gfhuth/ecg-instru/kicad/ecg-instru/ecg-instru.kicad_pcb

## KiCad design kicad/ecg-instru/ecg-instru.kicad_pcb (2025-06-29)

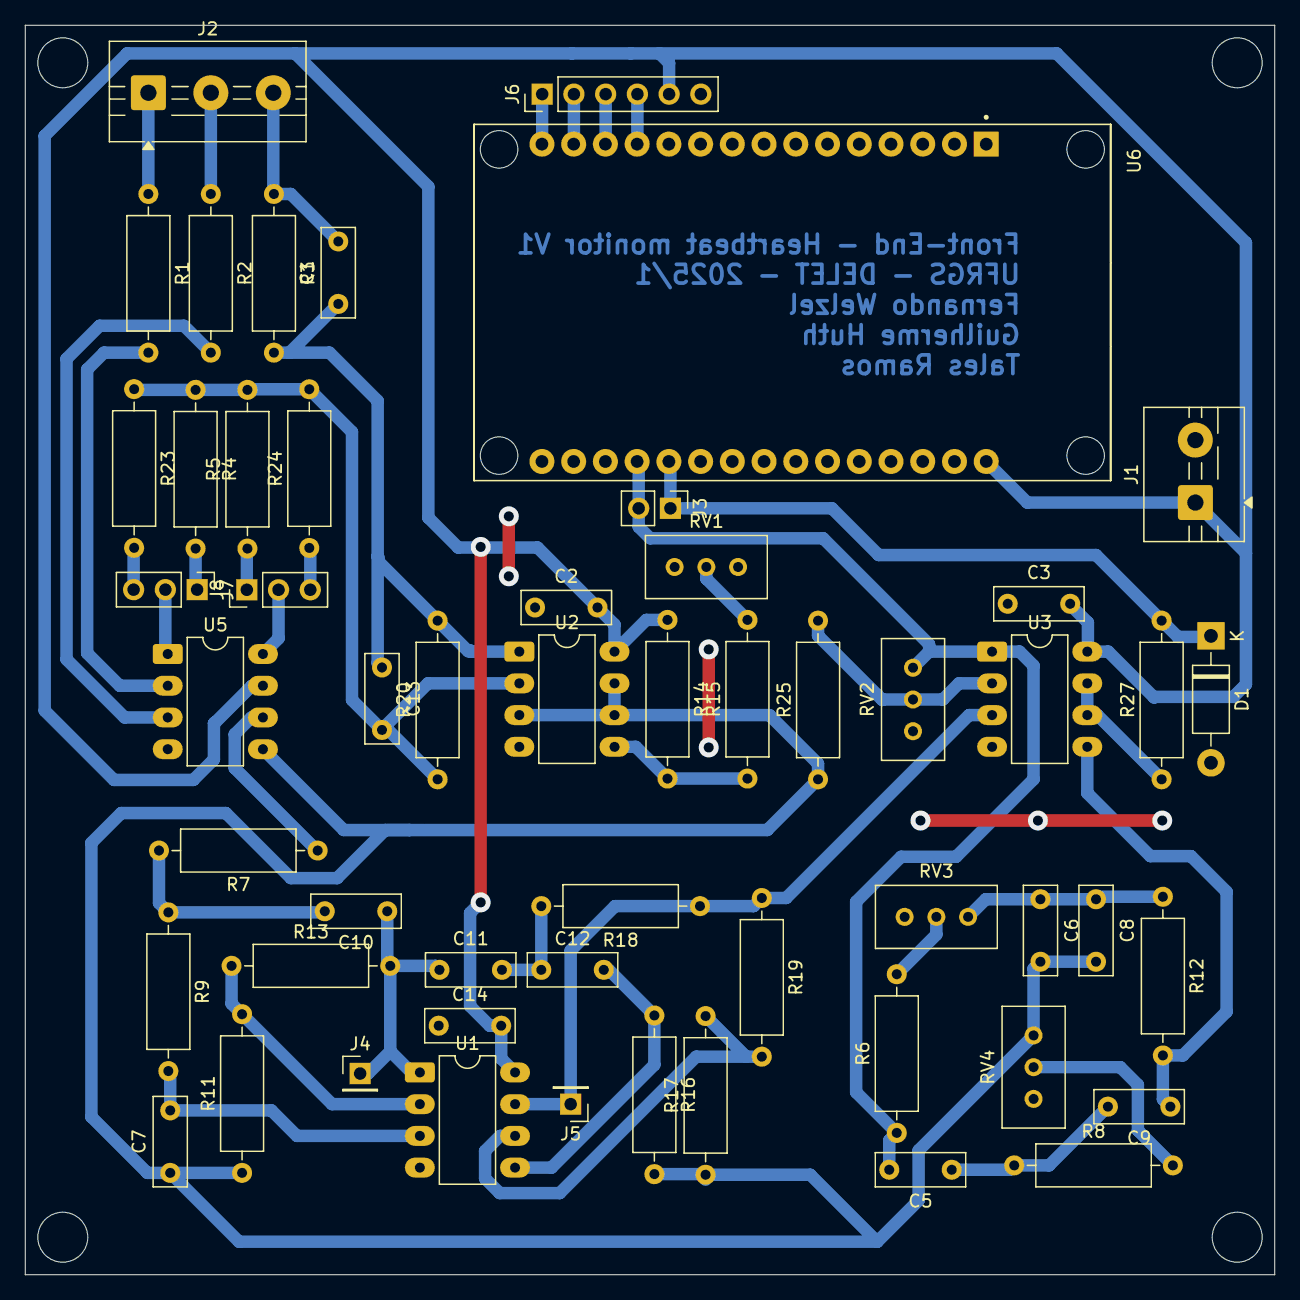
[picture p1: board ecg-instru.kicad_pcb from above]

Board: 2 copper layers, 100.0 x 100.0 mm, 54 parts (0 on the bottom side), 40 nets.

Parts:
C1, C13: 12n; C_Rect_L7.0mm_W2.5mm_P5.00mm
C2, C3, C14: 100n; C_Rect_L7.0mm_W2.5mm_P5.00mm
C5, C6, C8, C9: 47n; C_Rect_L7.0mm_W2.5mm_P5.00mm
C7, C10: 22n; C_Rect_L7.0mm_W2.5mm_P5.00mm
C11, C12: 220n; C_Rect_L7.0mm_W2.5mm_P5.00mm
D1: 3V3; D_DO-41_SOD81_P10.16mm_Horizontal
J1: Screw_Terminal_01x02; TerminalBlock_MaiXu_MX126-5.0-02P_1x02_P5.00mm
J2: Screw_Terminal_01x03; TerminalBlock_MaiXu_MX126-5.0-03P_1x03_P5.00mm
J3: Conn_01x02_Socket; PinHeader_1x02_P2.54mm_Vertical
J4, J5: Conn_01x01_Socket; PinHeader_1x01_P2.54mm_Vertical
J6: Conn_01x06_Socket; PinHeader_1x06_P2.54mm_Vertical
J7, J8: Conn_01x03_Socket; PinHeader_1x03_P2.54mm_Vertical
R1, R2, R3, R20: 220k; R_Axial_DIN0309_L9.0mm_D3.2mm_P12.70mm_Horizontal
R4, R5, R25, R27: 1k; R_Axial_DIN0309_L9.0mm_D3.2mm_P12.70mm_Horizontal
R6, R12: 56k; R_Axial_DIN0309_L9.0mm_D3.2mm_P12.70mm_Horizontal
R7, R9: 180k; R_Axial_DIN0309_L9.0mm_D3.2mm_P12.70mm_Horizontal
R8: 27k; R_Axial_DIN0309_L9.0mm_D3.2mm_P12.70mm_Horizontal
R11, R13, R17, R19: 10k; R_Axial_DIN0309_L9.0mm_D3.2mm_P12.70mm_Horizontal
R14: 5k6; R_Axial_DIN0309_L9.0mm_D3.2mm_P12.70mm_Horizontal
R15: 2k2; R_Axial_DIN0309_L9.0mm_D3.2mm_P12.70mm_Horizontal
R16, R18: 1M5; R_Axial_DIN0309_L9.0mm_D3.2mm_P12.70mm_Horizontal
R23, R24: 12k; R_Axial_DIN0309_L9.0mm_D3.2mm_P12.70mm_Horizontal
RV1, RV3: 1k; Potentiometer_Bourns_3296W_Vertical
RV2: 10k; Potentiometer_Bourns_3296W_Vertical
RV4: 2k; Potentiometer_Bourns_3296W_Vertical
U1, U2, U3: LM358; DIP-8_W7.62mm_LongPads
U5: INA114; DIP-8_W7.62mm_LongPads
U6: ESP32-DEVKIT-V1; MODULE_ESP32_DEVKIT_V1

Connections:
0: C2.1, C3.1, C14.1, D1.2 (A), J1.2, J6.6, RV1.1, U1.4 (V-), U2.4 (V-), U3.4 (V-), U5.4 (V-), U6.2 (GND), U6.29 (GND)
+5V: C2.2, C3.2, C14.2, J1.1, J6.5, R14.1, U1.8 (V+), U2.8 (V+), U3.8 (V+), U5.7 (V+), U6.30 (VIN)
B0: J6.2, U6.14 (D22)
B1: J6.1, U6.15 (D23)
COM: C13.2, R4.1, R5.2, R20.1, R23.1, R24.2, U2.2 (-)
GNDREF: C6.2, C7.1, C8.2, R11.1, R16.2, R17.1, R25.1, RV4.1, U2.3 (+), U2.6 (-), U2.7, U5.5 (Ref)
I2C1_SCL: J6.3, U6.13 (TX0)
I2C1_SDA: J6.4, U6.12 (RX0)
LA: R1.2, U5.2 (-)
LA_E: J2.1, R1.1
unnamed: C5.1, C9.2, R8.1
unnamed: C6.1, C8.1, R12.1, RV3.1
unnamed: C10.2, R7.2, R9.1
unnamed: C11.2, C12.1, R18.2
unnamed: C10.1, C11.1, J4.1, R13.2, U1.1
unnamed: J5.1, R18.1, R19.1, U1.7, U3.3 (+)
unnamed: J7.1, R4.2
unnamed: J7.2, U5.1 (Rg)
unnamed: J7.3, R23.2
unnamed: J8.1, R5.1
unnamed: J8.2, U5.8 (Rg)
unnamed: J8.3, R24.1
unnamed: R6.2, RV3.2
unnamed: R8.2, RV4.2
unnamed: R15.2, RV1.2
unnamed: C7.2, R9.2, U1.3 (+)
unnamed: R11.2, R13.1, U1.2 (-)
unnamed: C12.2, R16.1, U1.5 (+)
unnamed: R17.2, R19.2, U1.6 (-)
unnamed: R14.2, R15.1, U2.5 (+)
unnamed: R25.2, RV2.2, U3.2 (-)
unnamed: C9.1, R12.2, U3.5 (+)
unnamed: R27.1, U3.6 (-), U3.7
RA: R2.2, U5.3 (+)
RA_E: J2.2, R2.1
RL: C1.1, C13.1, R3.2, R20.2, U2.1
RL_E: C1.2, J2.3, R3.1
VADC: D1.1 (K), J3.1, R27.2, U6.20 (D35)
VINA: R7.1, U5.6
VSENSE: C5.2, J3.2, R6.1, RV2.1, U3.1, U6.19 (D34)
