gfhuth/ecg-instru/(commit log)

2025-06-16 First schematic version
    [ecg-instru.kicad_pcb, ecg-instru.kicad_sch]
2025-06-21 New schematic with correct components
    [conditioning.kicad_sch, ecg-instru.kicad_pcb, ecg-instru.kicad_sch]
2025-06-29 Board layout + Schematic + ESP32 initial src
    [conditioning.kicad_sch, ecg-instru.kicad_pcb, ecg-instru.kicad_sch]
2025-07-06 funcionando 500hz
